petejan/strain-gauge-logger/README.md

# strain-gauge-logger

Logging for adc122c04 24 bit ADC using arduino/SAMD21.
