petejan/strain-gauge-logger/docs/KSH-33600-2946800.pdf

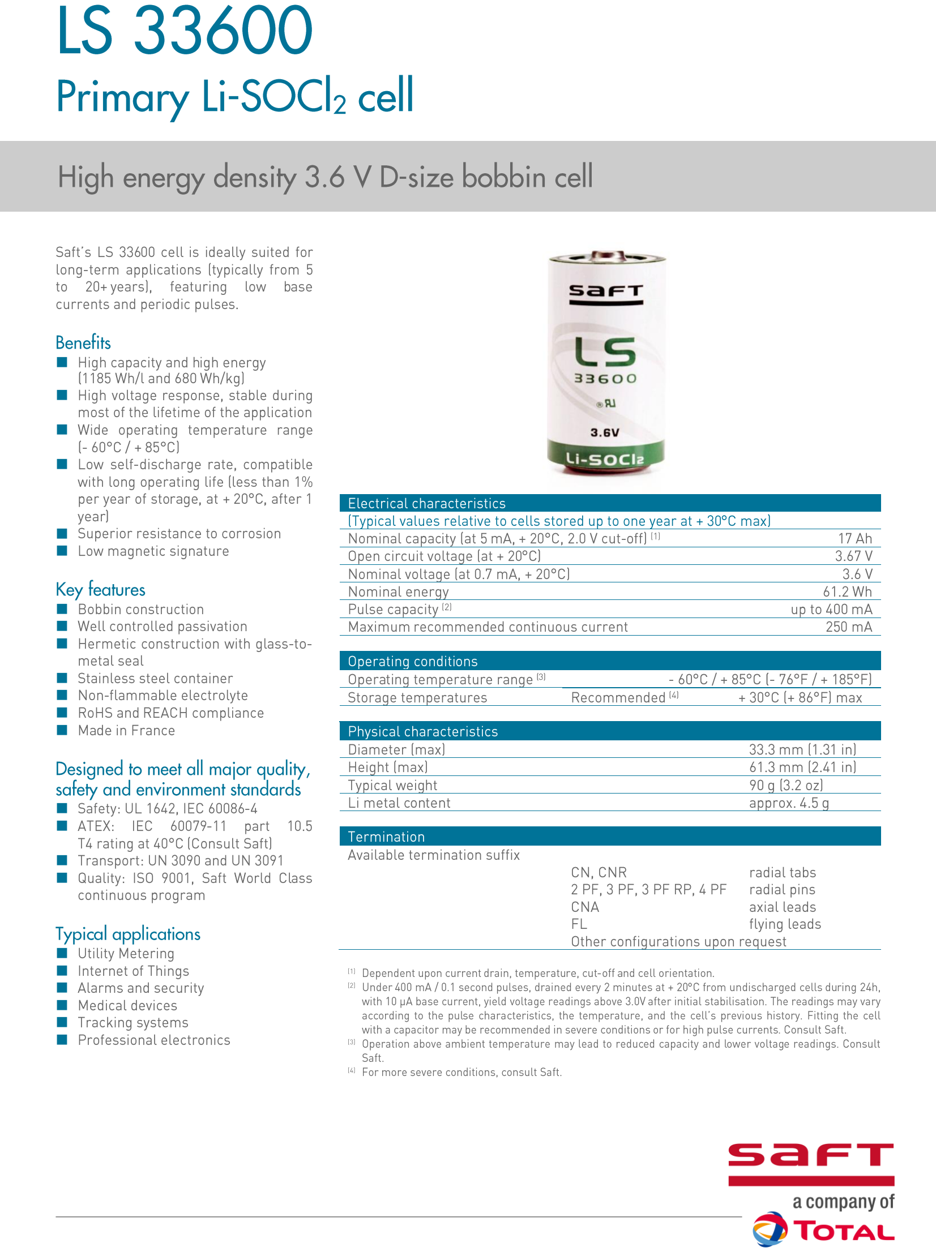
[picture p10: page 1]

◼◼◼◼◼◼◼◼◼◼◼◼◼◼◼◼◼◼◼◼◼◼◼

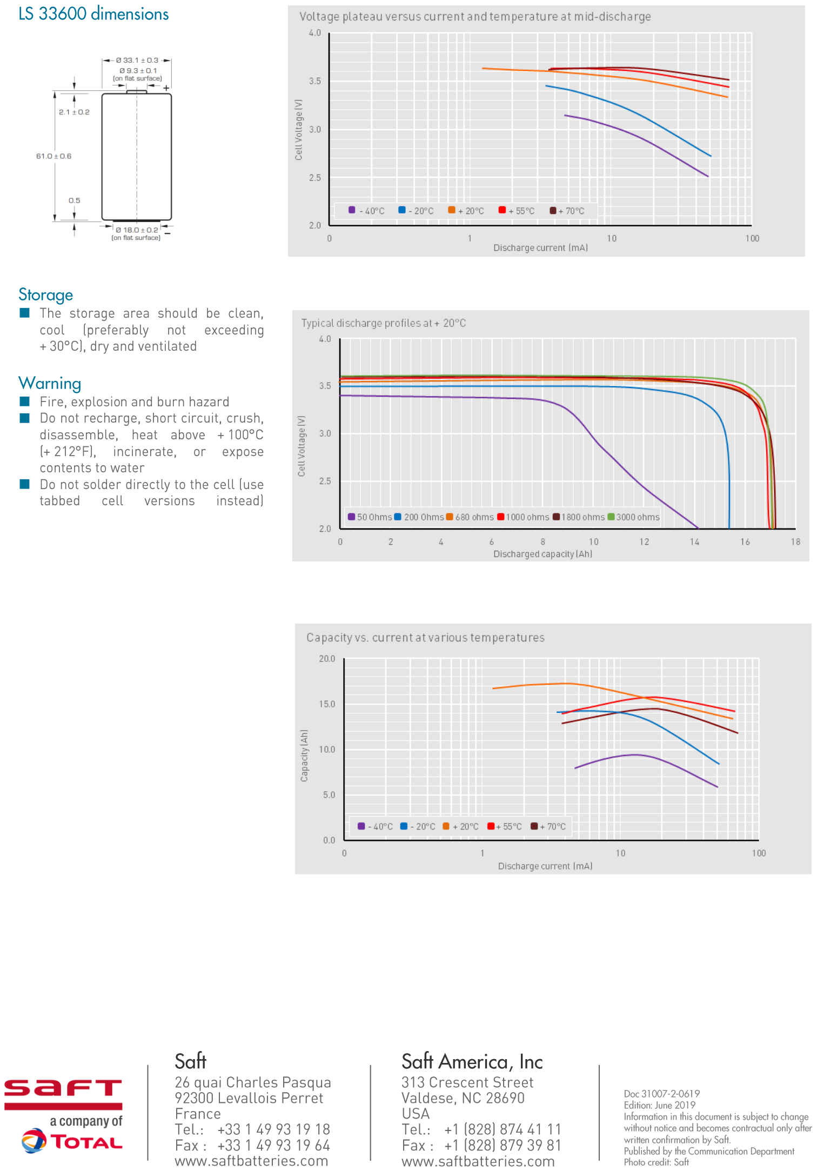
[picture p11: page 2]

◼◼◼◼
