petejan/strain-gauge-logger/hardware/ads1220-BOM.csv

Reference | Qty | Value | DNP | Exclude from BOM | Exclude from Board | Footprint | Datasheet
C1,C12,C13,C14 | 4 | 100n |  |  |  | Capacitor_SMD:C_0805_2012Metric_Pad1.18x1.45mm_HandSolder | ~
C2 | 1 | 10u |  |  |  | Capacitor_SMD:C_0805_2012Metric_Pad1.18x1.45mm_HandSolder | ~
C3,C4,C5,C6,C7,C8,C9,C10,C11 | 9 | 10n |  |  |  | Capacitor_SMD:C_0805_2012Metric_Pad1.18x1.45mm_HandSolder | ~
C15 | 1 | 2u2 |  |  |  | Capacitor_SMD:C_0805_2012Metric_Pad1.18x1.45mm_HandSolder | ~
C16 | 1 | 470p |  |  |  | Capacitor_SMD:C_0805_2012Metric_Pad1.15x1.40mm_HandSolder | ~
J1,J2 | 2 | Conn_01x04_Female |  |  |  | Connector_Molex:Molex_Nano-Fit_105314-xx04_2x02_P2.50mm_Horizontal | ~
R1,R2,R7,R8,R16,R18 | 6 | 0 |  |  |  | Resistor_SMD:R_0805_2012Metric_Pad1.20x1.40mm_HandSolder | ~
R3,R4,R5,R6 | 4 | 10 |  |  |  | Resistor_SMD:R_0805_2012Metric_Pad1.20x1.40mm_HandSolder | ~
R10,R11,R13 | 3 | 100 |  |  |  | Resistor_SMD:R_0805_2012Metric_Pad1.20x1.40mm_HandSolder | ~
R14,R15,R17,R19,R20 | 5 | 10k |  |  |  | Resistor_SMD:R_0805_2012Metric_Pad1.20x1.40mm_HandSolder | ~
U1 | 1 | LM4140-1.25 |  |  |  | Package_SO:SOIC-8_3.9x4.9mm_P1.27mm | http://www.ti.com/lit/ds/symlink/ref5030.pdf
U2 | 1 | MIC5205-2.5YM5 |  |  |  | Package_TO_SOT_SMD:SOT-23-5 | http://ww1.microchip.com/downloads/en/DeviceDoc/20005785A.pdf
U3 | 1 | ADS1220 |  |  |  | Package_SO:TSSOP-16_4.4x5mm_P0.65mm | http://www.ti.com/lit/ds/symlink/ads1120.pdf
