petejan/strain-gauge-logger/hardware/ads1220/ads1220.pdf

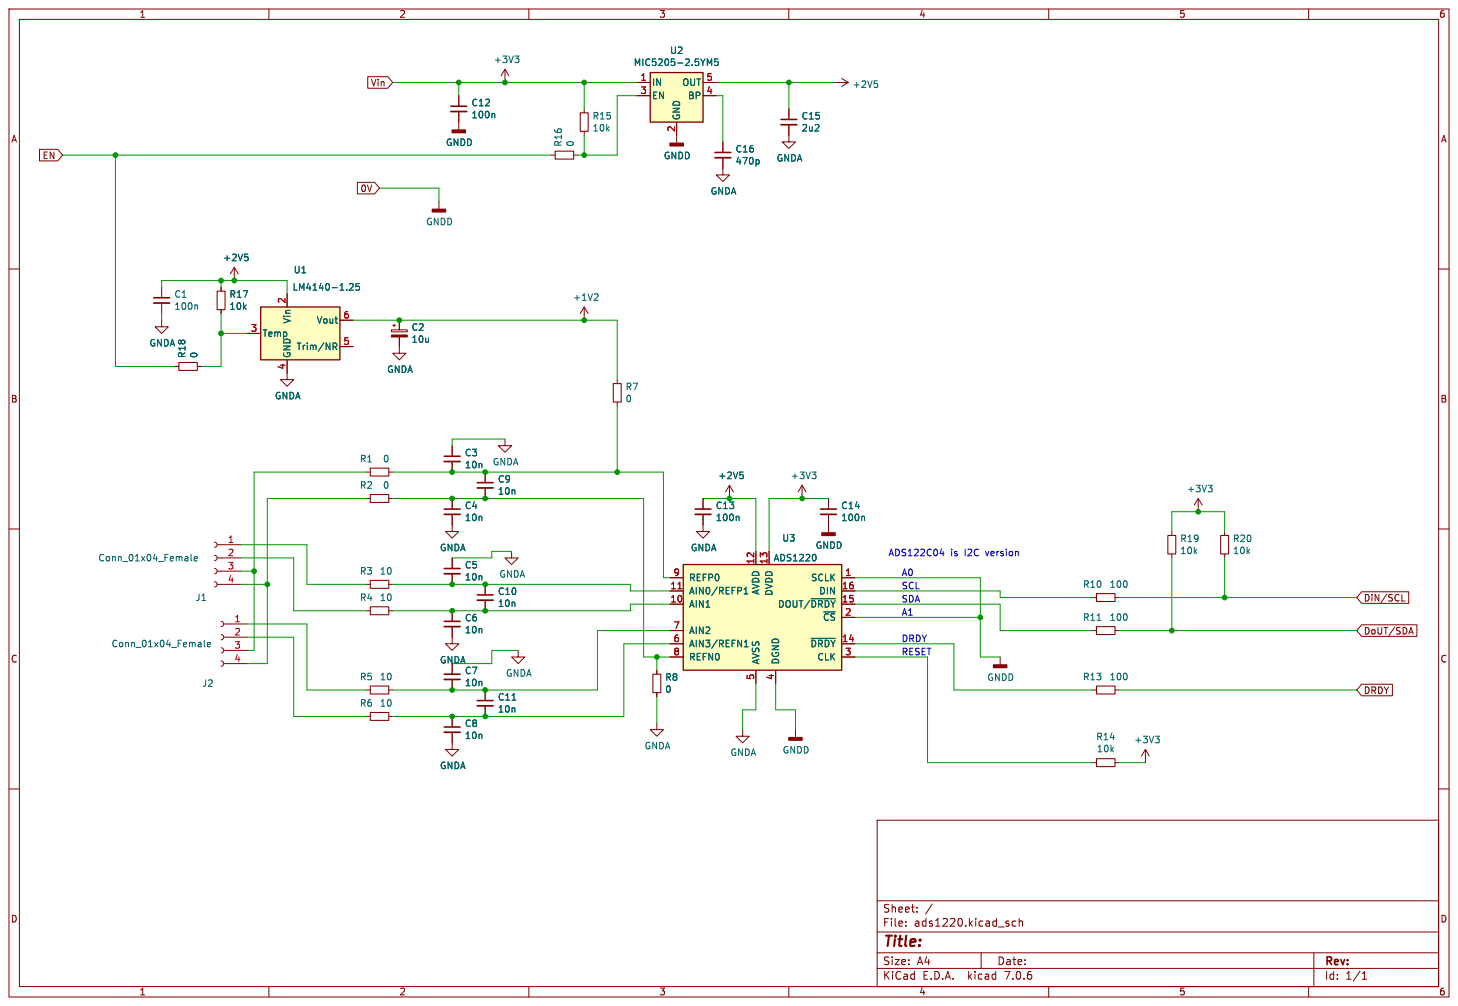
[picture p12: page 1]

2 EN 3 BP 4 OUT 5 U2 MIC5205-2.5YM5 +3V3 GNDD

2 EN 3 BP 4 OUT 5 GNDD C16

4 Trim/NR 5 Vout 6 GNDA R17

Id: 1/1 Title: File: ads1220.kicad_sch Sheet: / GNDA R7
