petejan/strain-gauge-logger/docs/strain-gauge-logger-Wiring-diagram.pdf

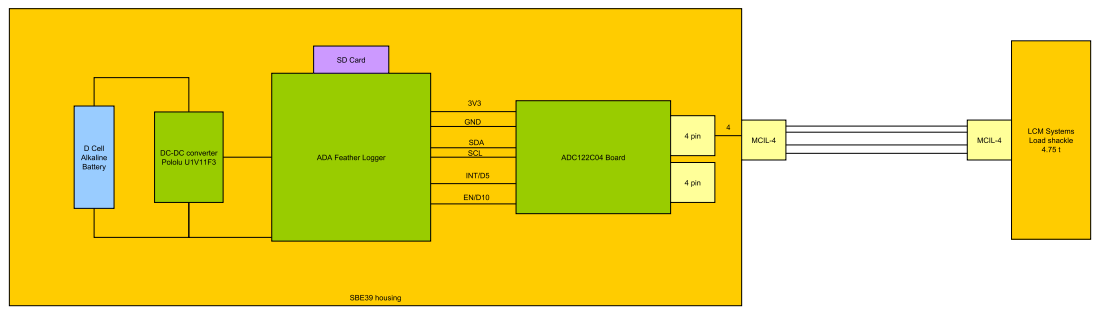
[picture p13: page 1]
