petejan/strain-gauge-logger/hardware/ads1220/ads1220_PCB.pdf

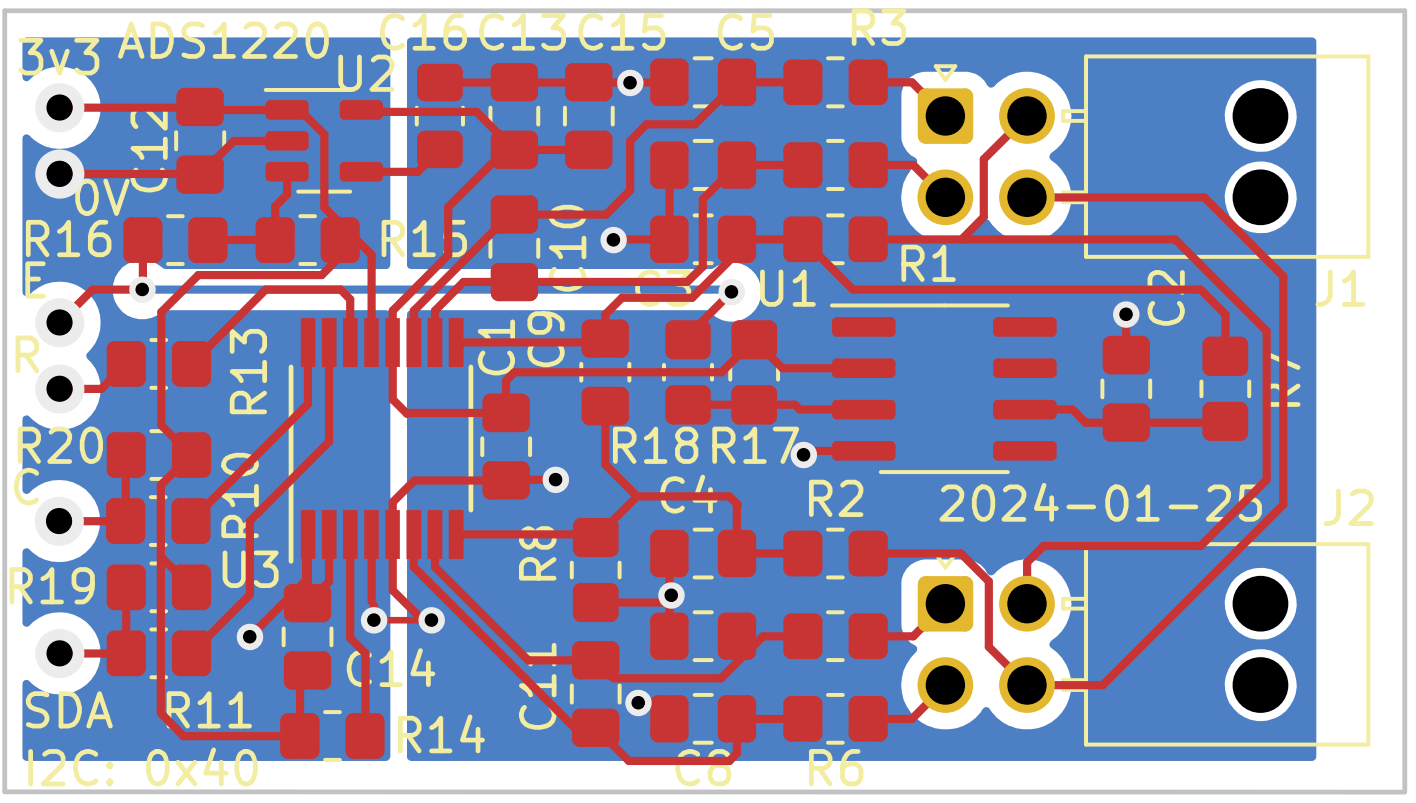
[picture p14: page 1]
