petejan/strain-gauge-logger/hardware/ads1220.kicad_pcb

## KiCad design hardware/ads1220.kicad_pcb (2024-02-01)

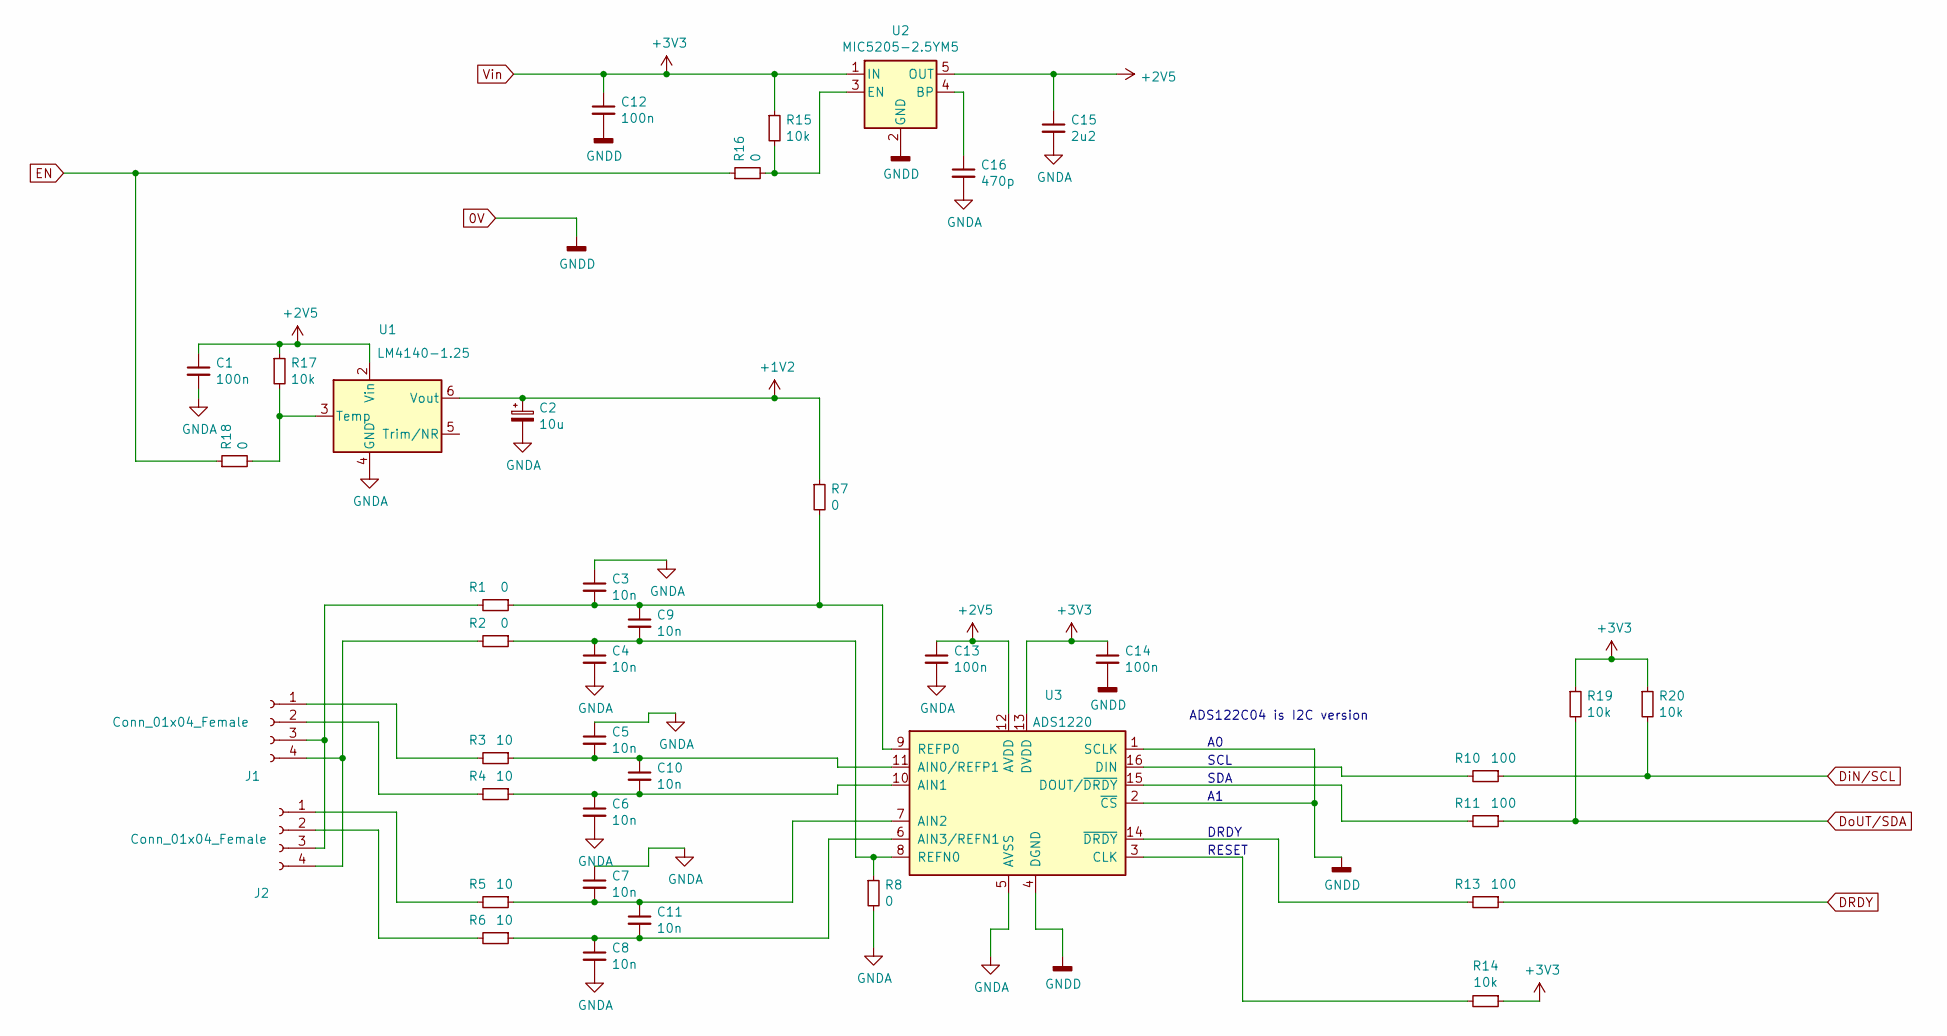
[picture p15: schematic ads1220.kicad_sch]

Parts:
C1, C12, C13, C14: 100n; C_0805_2012Metric_Pad1.18x1.45mm_HandSolder
C2: 10u; C_0805_2012Metric_Pad1.18x1.45mm_HandSolder
C3, C4, C5, C6, C7, C8, C9, C10, C11: 10n; C_0805_2012Metric_Pad1.18x1.45mm_HandSolder
C15: 2u2; C_0805_2012Metric_Pad1.18x1.45mm_HandSolder
C16: 470p; C_0805_2012Metric_Pad1.15x1.40mm_HandSolder
J1, J2: Conn_01x04_Female; Molex_Nano-Fit_105314-xx04_2x02_P2.50mm_Horizontal
R1, R2, R7, R8, R16, R18: 0; R_0805_2012Metric_Pad1.20x1.40mm_HandSolder
R3, R4, R5, R6: 10; R_0805_2012Metric_Pad1.20x1.40mm_HandSolder
R10, R11, R13: 100; R_0805_2012Metric_Pad1.20x1.40mm_HandSolder
R14, R15, R17, R19, R20: 10k; R_0805_2012Metric_Pad1.20x1.40mm_HandSolder
U1: LM4140-1.25; SOIC-8_3.9x4.9mm_P1.27mm
U2: MIC5205-2.5YM5; SOT-23-5
U3: ADS1220; TSSOP-16_4.4x5mm_P0.65mm

Connections:
0V: C12.2, C14.2, U2.2 (GND), U3.1 (SCLK), U3.2 (~CS), U3.4 (DGND)
+1V2: C2.1, R7.1, U1.6 (Vout)
+2V5: C1.1, C13.1, C15.1, R17.1, U1.2 (Vin), U2.5 (OUT), U3.12 (AVDD)
DRDY: R13.1
DiN/SCL: R10.1, R20.2
DoUT/SDA: R11.1, R19.2
EN: R16.1, R18.1
GNDA: C1.2, C2.2, C3.1, C4.2, C5.1, C6.2, C7.1, C8.2, C13.2, C15.2, C16.2, R8.2, U1.4 (GND), U3.5 (AVSS)
unnamed: J1.1, R3.2
unnamed: J1.2, R4.2
unnamed: J1.3, J2.3, R1.2
unnamed: J1.4, J2.4, R2.2
unnamed: J2.1, R5.2
unnamed: J2.2, R6.2
unnamed: R17.2, R18.2, U1.3 (Temp)
unnamed: C16.1, U2.4 (BP)
unnamed: R15.2, R16.2, U2.3 (EN)
unnamed: C5.2, C10.1, R3.1, U3.11 (AIN0/REFP1)
unnamed: C6.1, C10.2, R4.1, U3.10 (AIN1)
unnamed: C7.2, C11.1, R5.1, U3.7 (AIN2)
unnamed: C8.1, C11.2, R6.1, U3.6 (AIN3/REFN1)
unnamed: R14.2, U3.3 (CLK)
unnamed: R10.2, U3.16 (DIN)
unnamed: R11.2, U3.15 (DOUT/~DRDY)
unnamed: C4.1, C9.2, R2.1, R8.1, U3.8 (REFN0)
unnamed: C3.2, C9.1, R1.1, R7.2, U3.9 (REFP0)
unnamed: R13.2, U3.14 (~DRDY)
Vin: C12.1, C14.1, R14.1, R15.1, R19.1, R20.1, U2.1 (IN), U3.13 (DVDD)

Notes on the sheet:
SDA
ADS122C04 is I2C version
RESET
DRDY
SCL

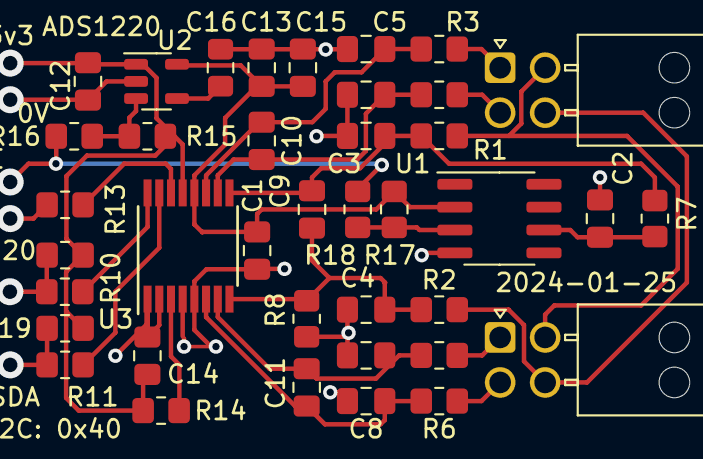
[picture p16: board ads1220.kicad_pcb from above]

Board: 2 copper layers, 39 parts (0 on the bottom side), 27 nets.
