petejan/strain-gauge-logger/(commit log)

2024-01-04 commit baseline arduino
    Changes files for 8 MHz osc
2024-01-04 datasheets and PCB mod to molex-minifit connector
2024-01-07 changes for QTPY
    change I2C port, and clocks, less Digital PINs
2024-01-09 Update adc122c04_direct.ino
    change external interrupt system clock to GEN02 so it runs in sleep mode.
2024-01-09 commit changes to arduioPlugin
    boards, startup and LowPower library changes
2024-01-11 Update adc122c04_direct.ino
    change to LOW interrupt trigger as can be asynchronous with GCLK
2024-01-12 Update adc122c04_direct.ino
    try fix missing samples in continuous mode
2024-01-16 found delayed adc reads, due to RTC sync delay
2024-01-30 Update adc122c04_direct.ino
    add bytes/sample configuration
2024-02-01 Update adc122c04_direct.ino
    change to 3 bytes/sample
2024-02-01 Update adc122c04_direct.ino
    document I2C baud rate
2024-02-01 commit PCB
2024-02-04 no DMA config
2024-02-12 disable I2C when sleep
    I2C pul up on SDA draw current in sleep mode.
2024-02-14 Update adc122c04_direct.ino
    add check for IDLE before sleep, causes missed samples
2024-03-02 add sensor detect mode
    Add RUN_MODE_DETECT
    change all prints to printf
    zmodem transfers
2024-03-18 divide main file into adc/i2c/timer/cmd
    separate functions from main source file
2026-01-05 add BOM list
2026-09-22 set i2c nack correctly, don't disable I2C pings when sleeping
    i2c pings was pulled up to 3v3 so don't need disabling
2026-10-18 add arduino-cli build/upload script
2026-10-21 fix timestamp on first sample
